kabelkao/Meteostanice/Foto/IMG_8637.JPG

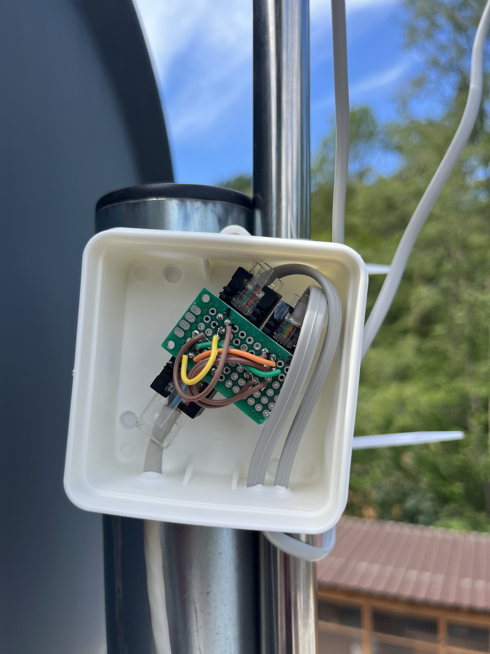
Foto/IMG_8637.JPG
