kabelkao/Meteostanice/Foto/IMG_8640.JPG

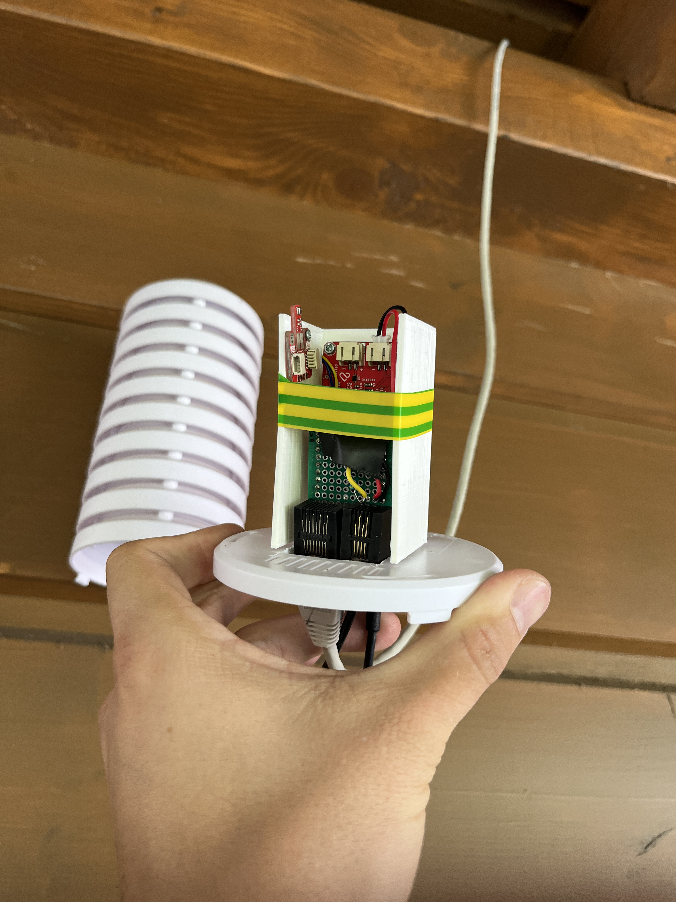
Foto/IMG_8640.JPG
