kabelkao/Meteostanice/Foto/IMG_8639.JPG

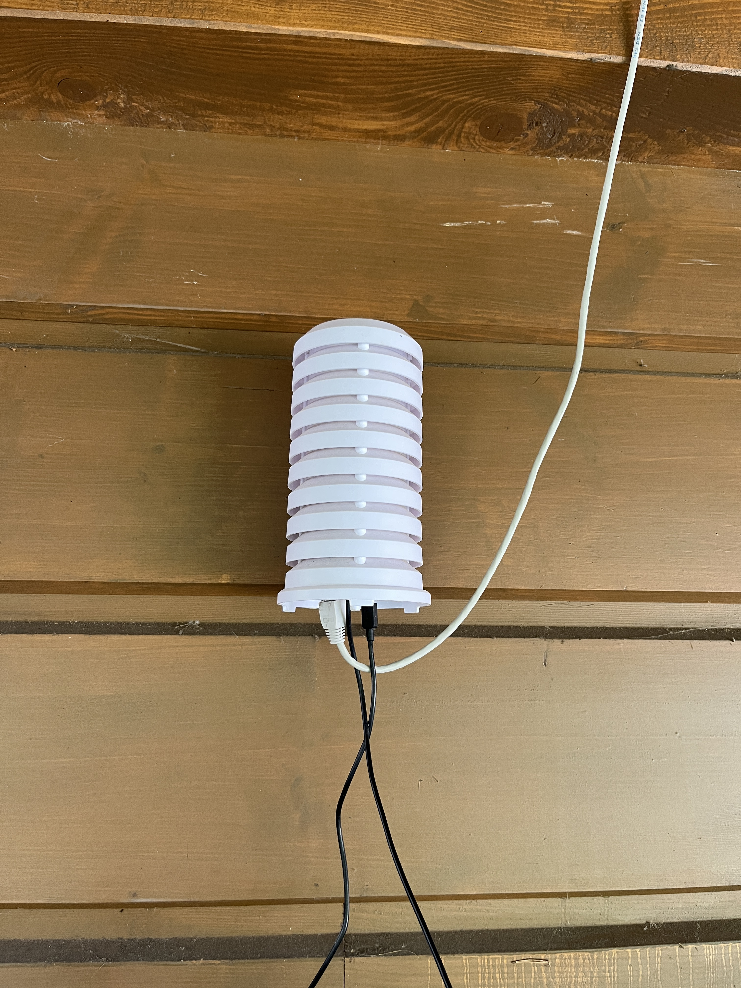
Foto/IMG_8639.JPG
