kabelkao/Meteostanice/Foto/IMG_8635.JPG

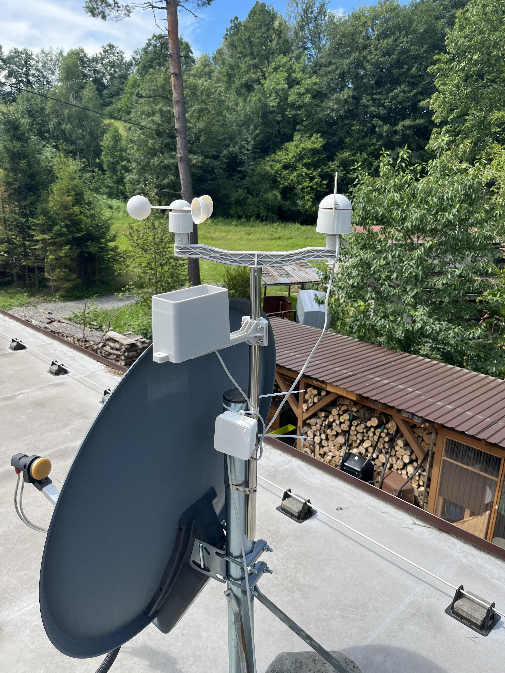
Foto/IMG_8635.JPG
